taskx6004/eMate-CM4/README.md

# eMate-CM4
Yet another CM4 form-factor design for eMate laptop conversion kit.
