taskx6004/eMate-CM4/CM4_1S/step/BK11C0.6-10DS6-0.35V.stp

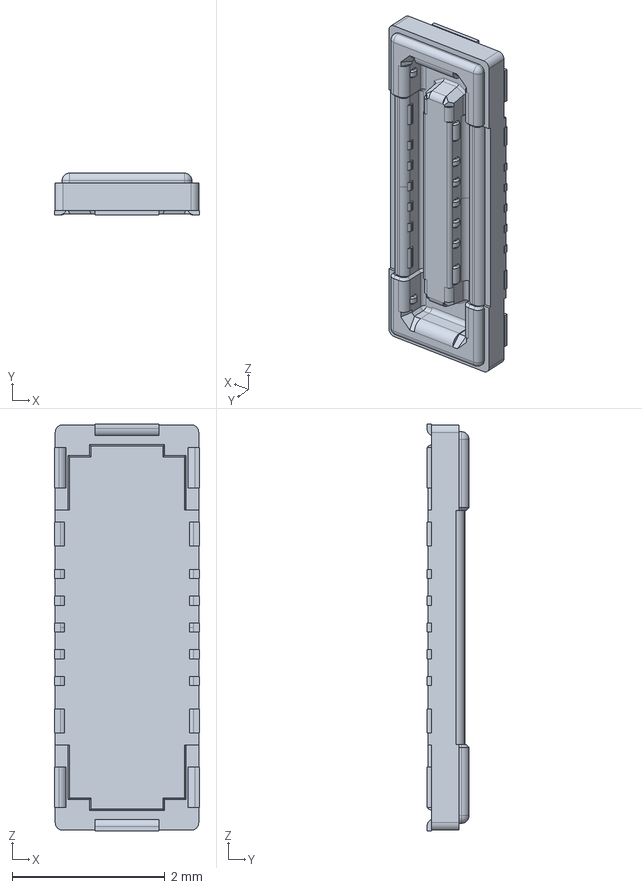
[picture p1: CAD file, 2024-03-10]
CM4_1S/step/BK11C0.6-10DS6-0.35V.stp
1.90 x 0.55 x 5.33 mm
