taskx6004/eMate-CM4/CM4_1S/step/FH34SRJ-22S-0.5SH(50).stp

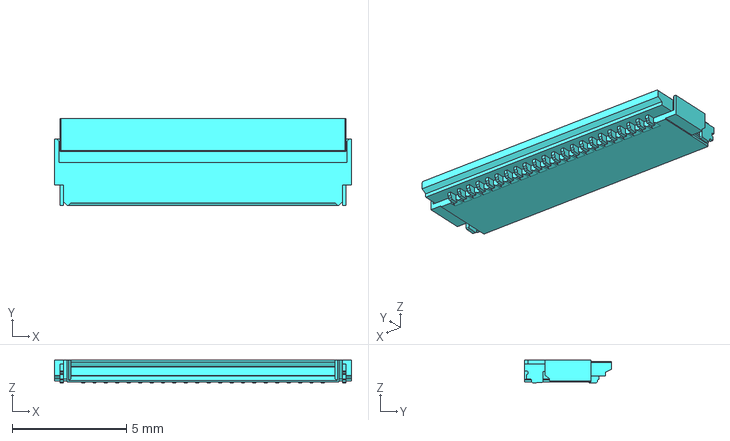
[picture p2: CAD file, 2024-03-10]
CM4_1S/step/FH34SRJ-22S-0.5SH(50).stp
13.0 x 3.80 x 1.00 mm
