taskx6004/eMate-CM4/CM4_1S/step/DF58-2P-1.2V.stp

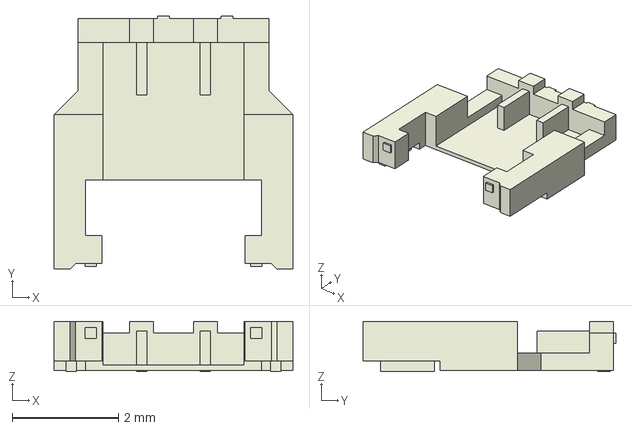
[picture p3: CAD file, 2024-03-10]
CM4_1S/step/DF58-2P-1.2V.stp
4.50 x 4.77 x 0.95 mm
