taskx6004/eMate-CM4/CM4_1S/step/SF72S006VB.step

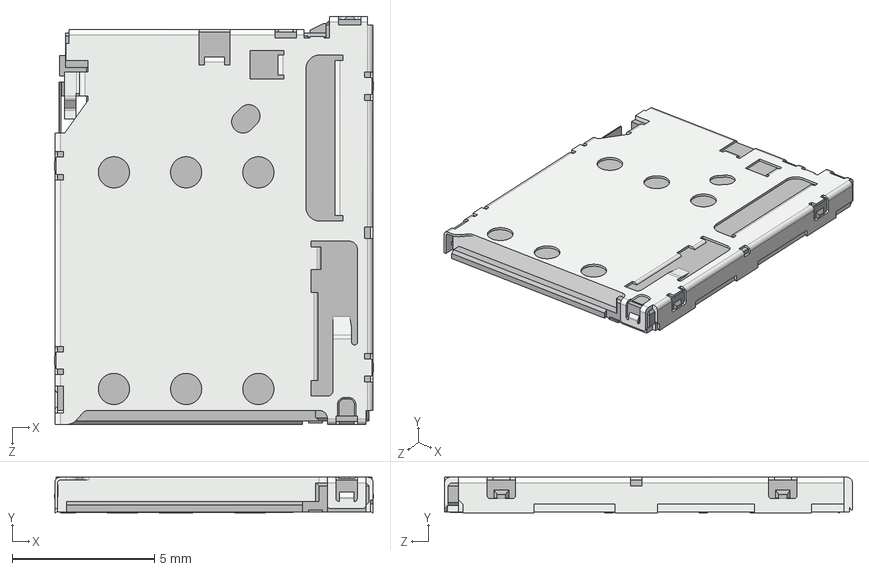
[picture p4: CAD file, 2024-03-10]
CM4_1S/step/SF72S006VB.step
11.2 x 1.25 x 14.4 mm
