taskx6004/eMate-CM4/CM4_1S/step/c-2199119-3-c-3d.stp

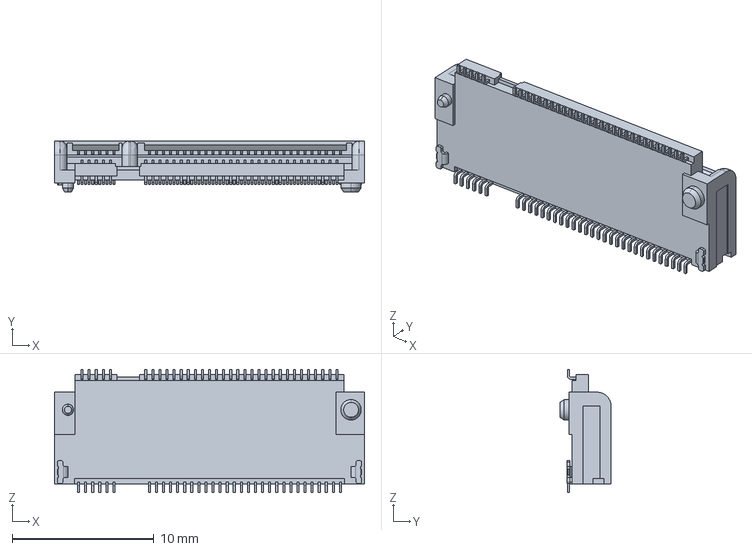
[picture p5: CAD file, 2024-03-10]
CM4_1S/step/c-2199119-3-c-3d.stp
21.9 x 3.62 x 8.70 mm
