taskx6004/eMate-CM4/CM4_1S/step/DF65-6P-1.7V.stp

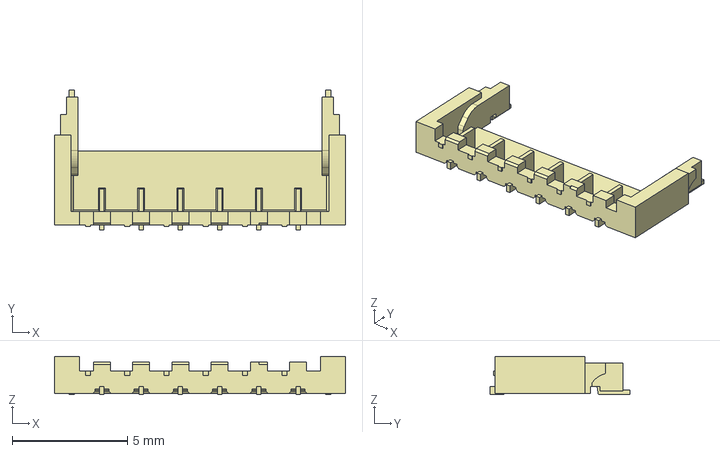
[picture p6: CAD file, 2024-03-10]
CM4_1S/step/DF65-6P-1.7V.stp
12.6 x 6.05 x 1.65 mm
