taskx6004/eMate-CM4/CM4_1S/step/2171790001.stp

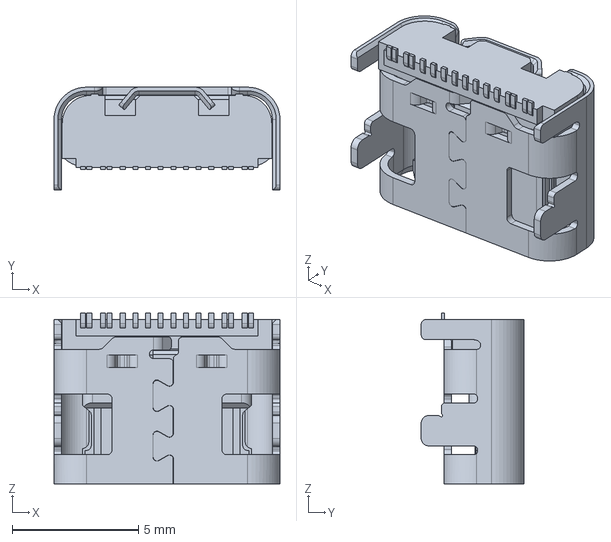
[picture p7: CAD file, 2024-03-10]
CM4_1S/step/2171790001.stp
8.94 x 4.06 x 6.75 mm
