taskx6004/eMate-CM4/CM4_1S/step/9774015151R.step

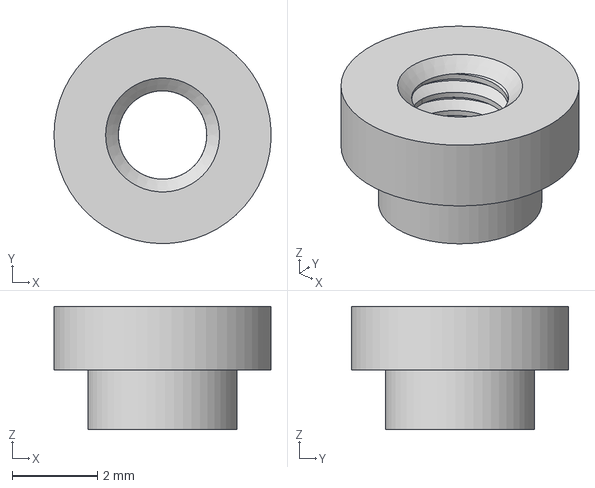
[picture p8: CAD file, 2024-03-10]
CM4_1S/step/9774015151R.step
5.10 x 5.10 x 2.90 mm
