taskx6004/eMate-CM4/CM4_1S/step/2012670005.stp

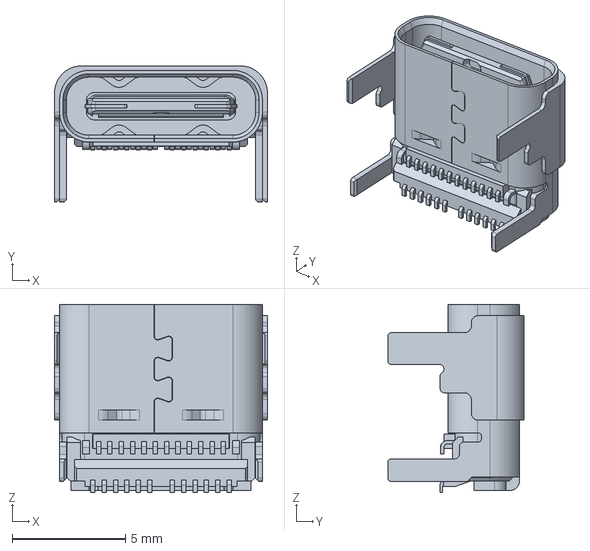
[picture p9: CAD file, 2024-03-10]
CM4_1S/step/2012670005.stp
9.39 x 6.01 x 8.30 mm
