taskx6004/eMate-CM4/CM4_1S/step/2171750001.stp

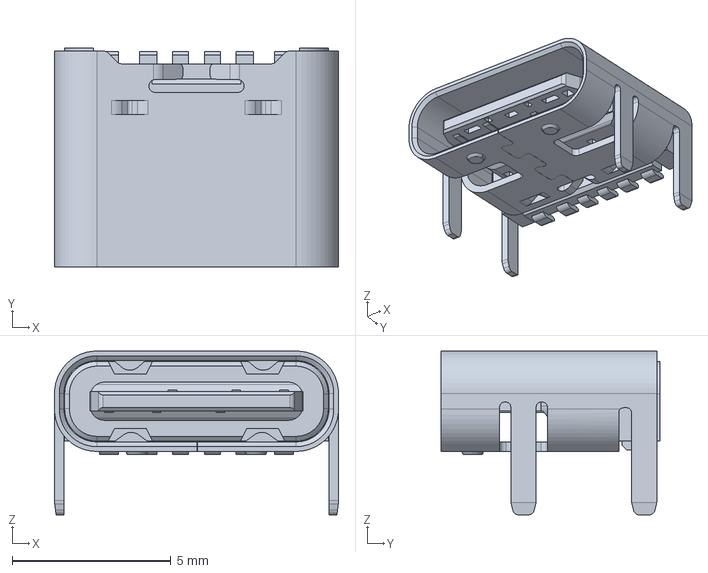
[picture p10: CAD file, 2024-03-10]
CM4_1S/step/2171750001.stp
8.94 x 6.90 x 5.16 mm
