taskx6004/eMate-CM4/CM4_1S/step/1050171001.stp

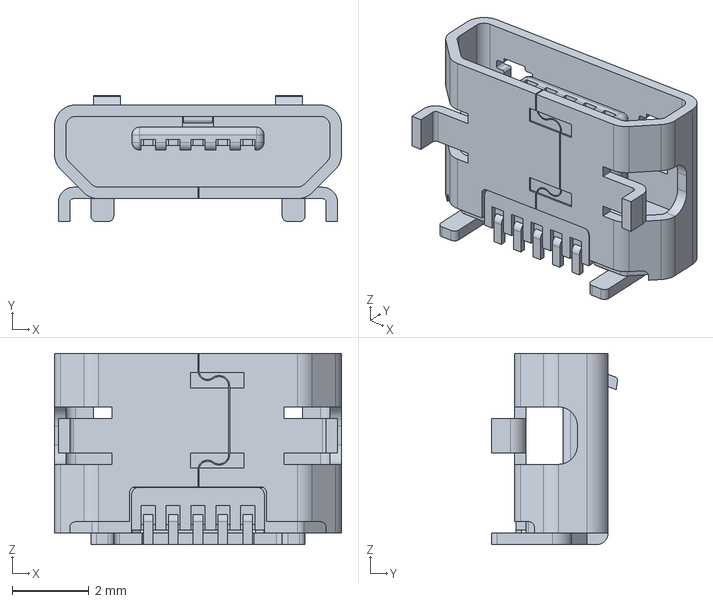
[picture p11: CAD file, 2024-03-10]
CM4_1S/step/1050171001.stp
7.50 x 3.30 x 5.00 mm
