taskx6004/eMate-CM4/CM4_1S/step/467651001.stp

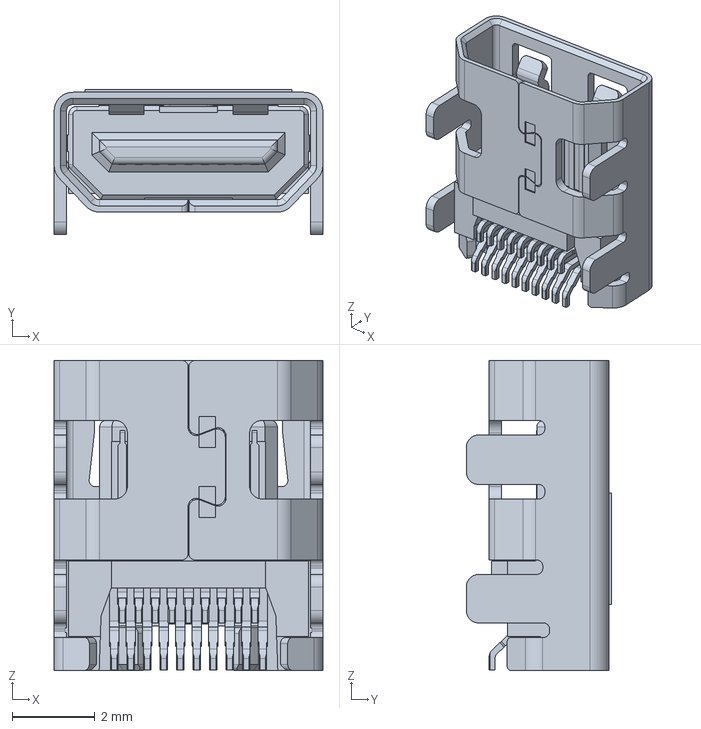
[picture p12: CAD file, 2024-03-10]
CM4_1S/step/467651001.stp
6.50 x 3.52 x 7.50 mm
