taskx6004/eMate-CM4/CM4_1S/step/5033981892.step

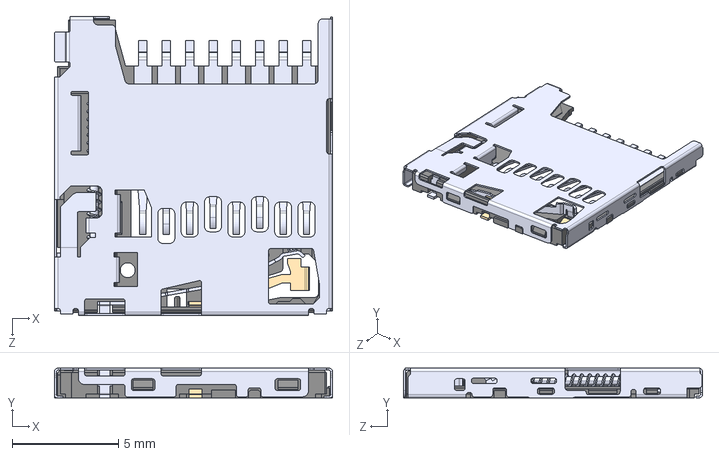
[picture p13: CAD file, 2024-03-10]
CM4_1S/step/5033981892.step
13.1 x 1.40 x 14.1 mm
