taskx6004/eMate-CM4/CM4_1S.pdf

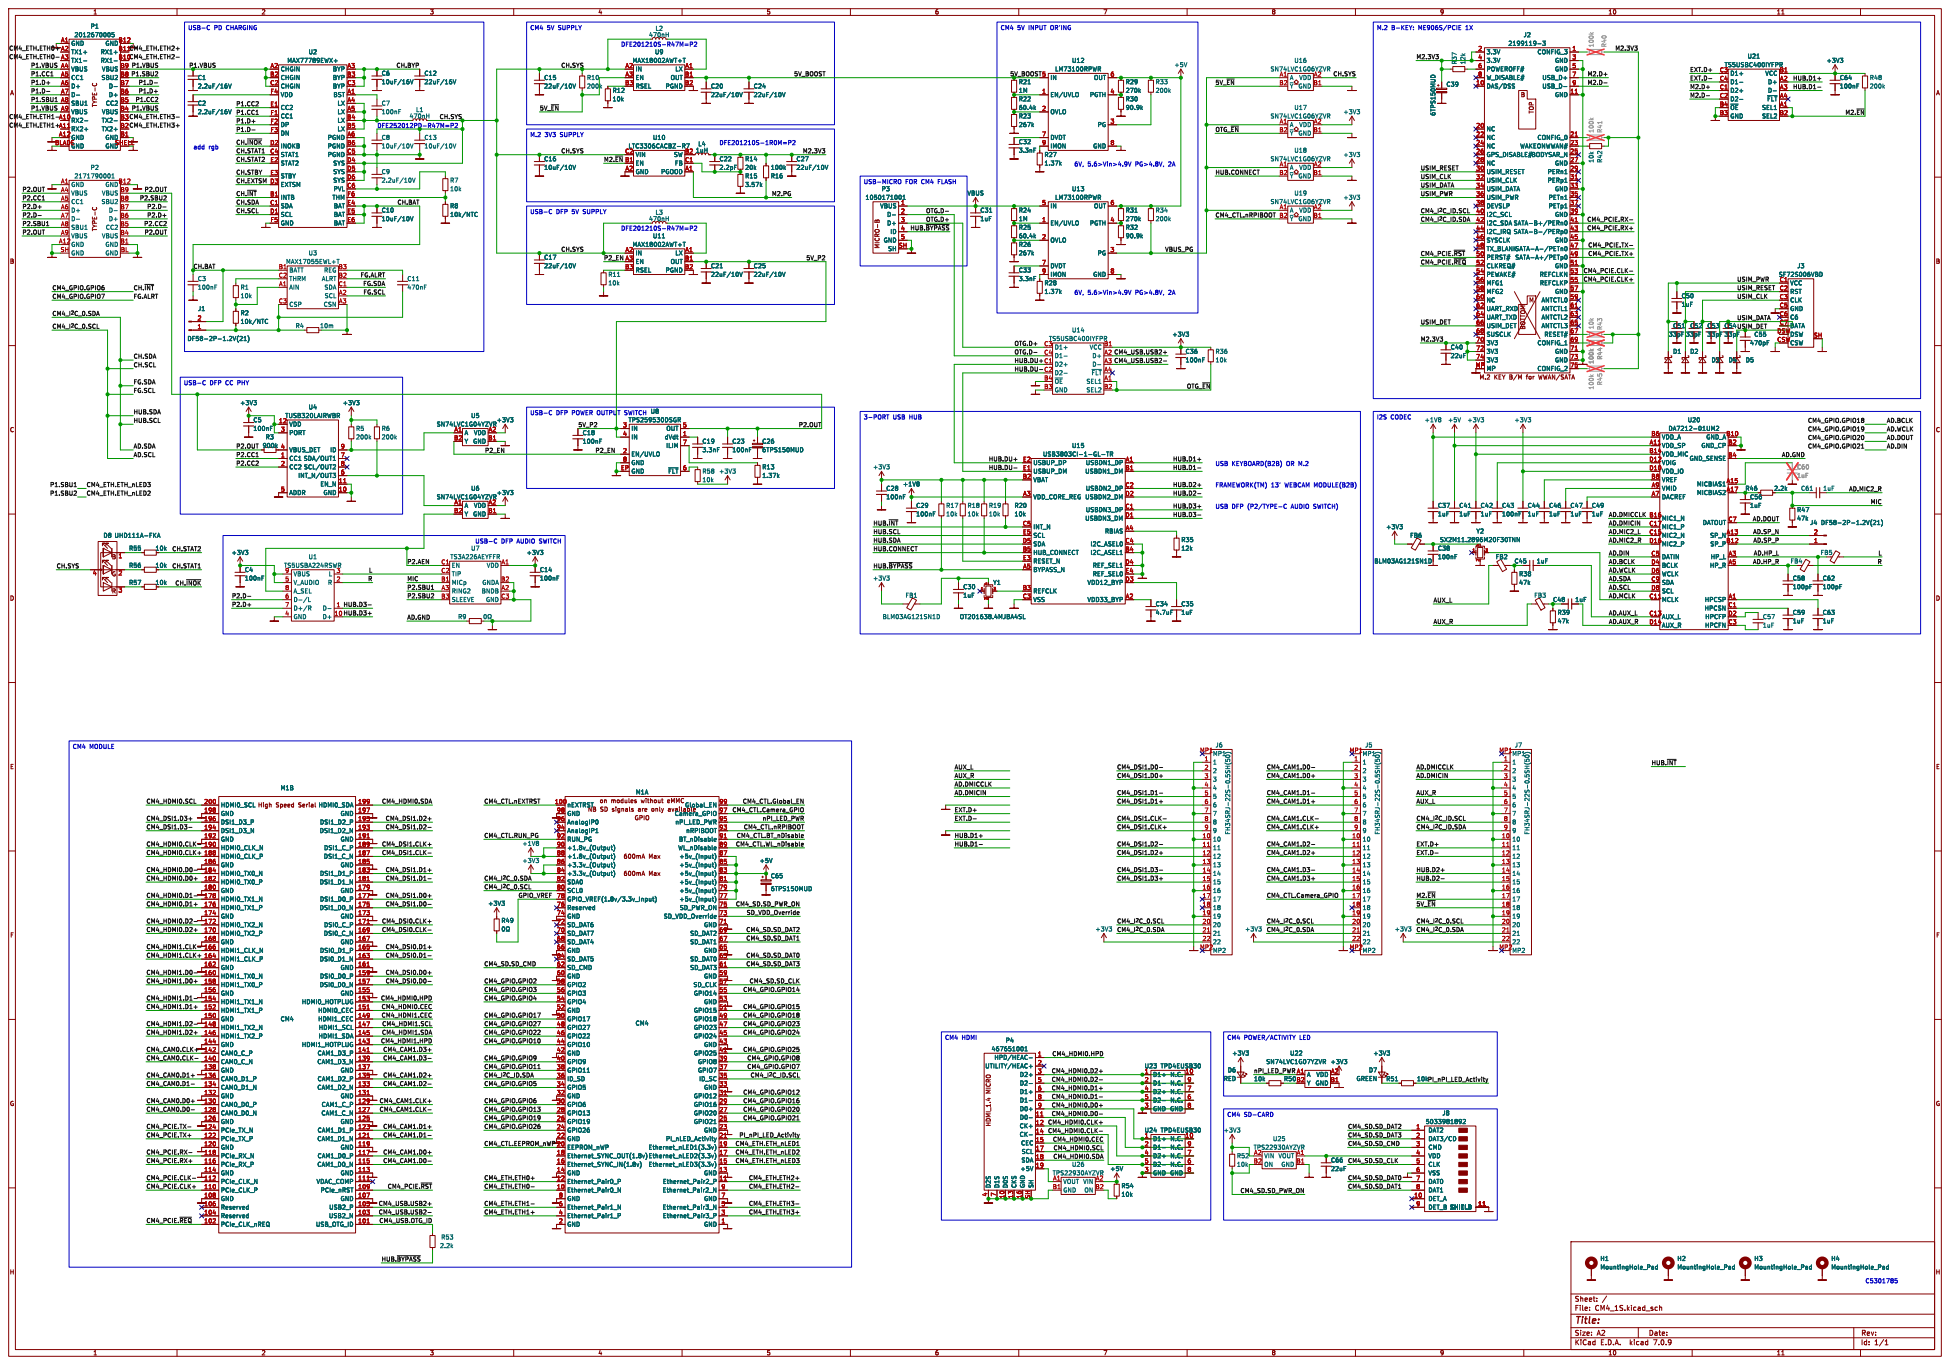
[picture p14: page 1]

CH.~{INOK} P1.D- P1.D+ P1.CC1 CH.SCL CH.EXTSM

ID 4 GND 5 VBUS 1 D- 2 D+ 3 SH SH

FG.SCL HUB.SCL HUB.SDA

USB-C DFP POWER OUTPUT SWITCH

AD.DOUT AD.BCLK
AD.WCLK

P2.CC2 P2.OUT P2.CC1 CH.STAT1 CH.~{INOK} CH.STAT2

C1 MCLK C11 AUX_L C13 MIC2_N
HUB.~{INT} AD.WCLK

EXT.D+ HUB.~{BYPASS} AD.GND HUB.D3+ HUB.D3-

AD.SCL AD.MCLK

600mA Max 600mA Max NB SD signals are only available
