taskx6004/eMate-CM4/eMate_CM4_KB.pdf

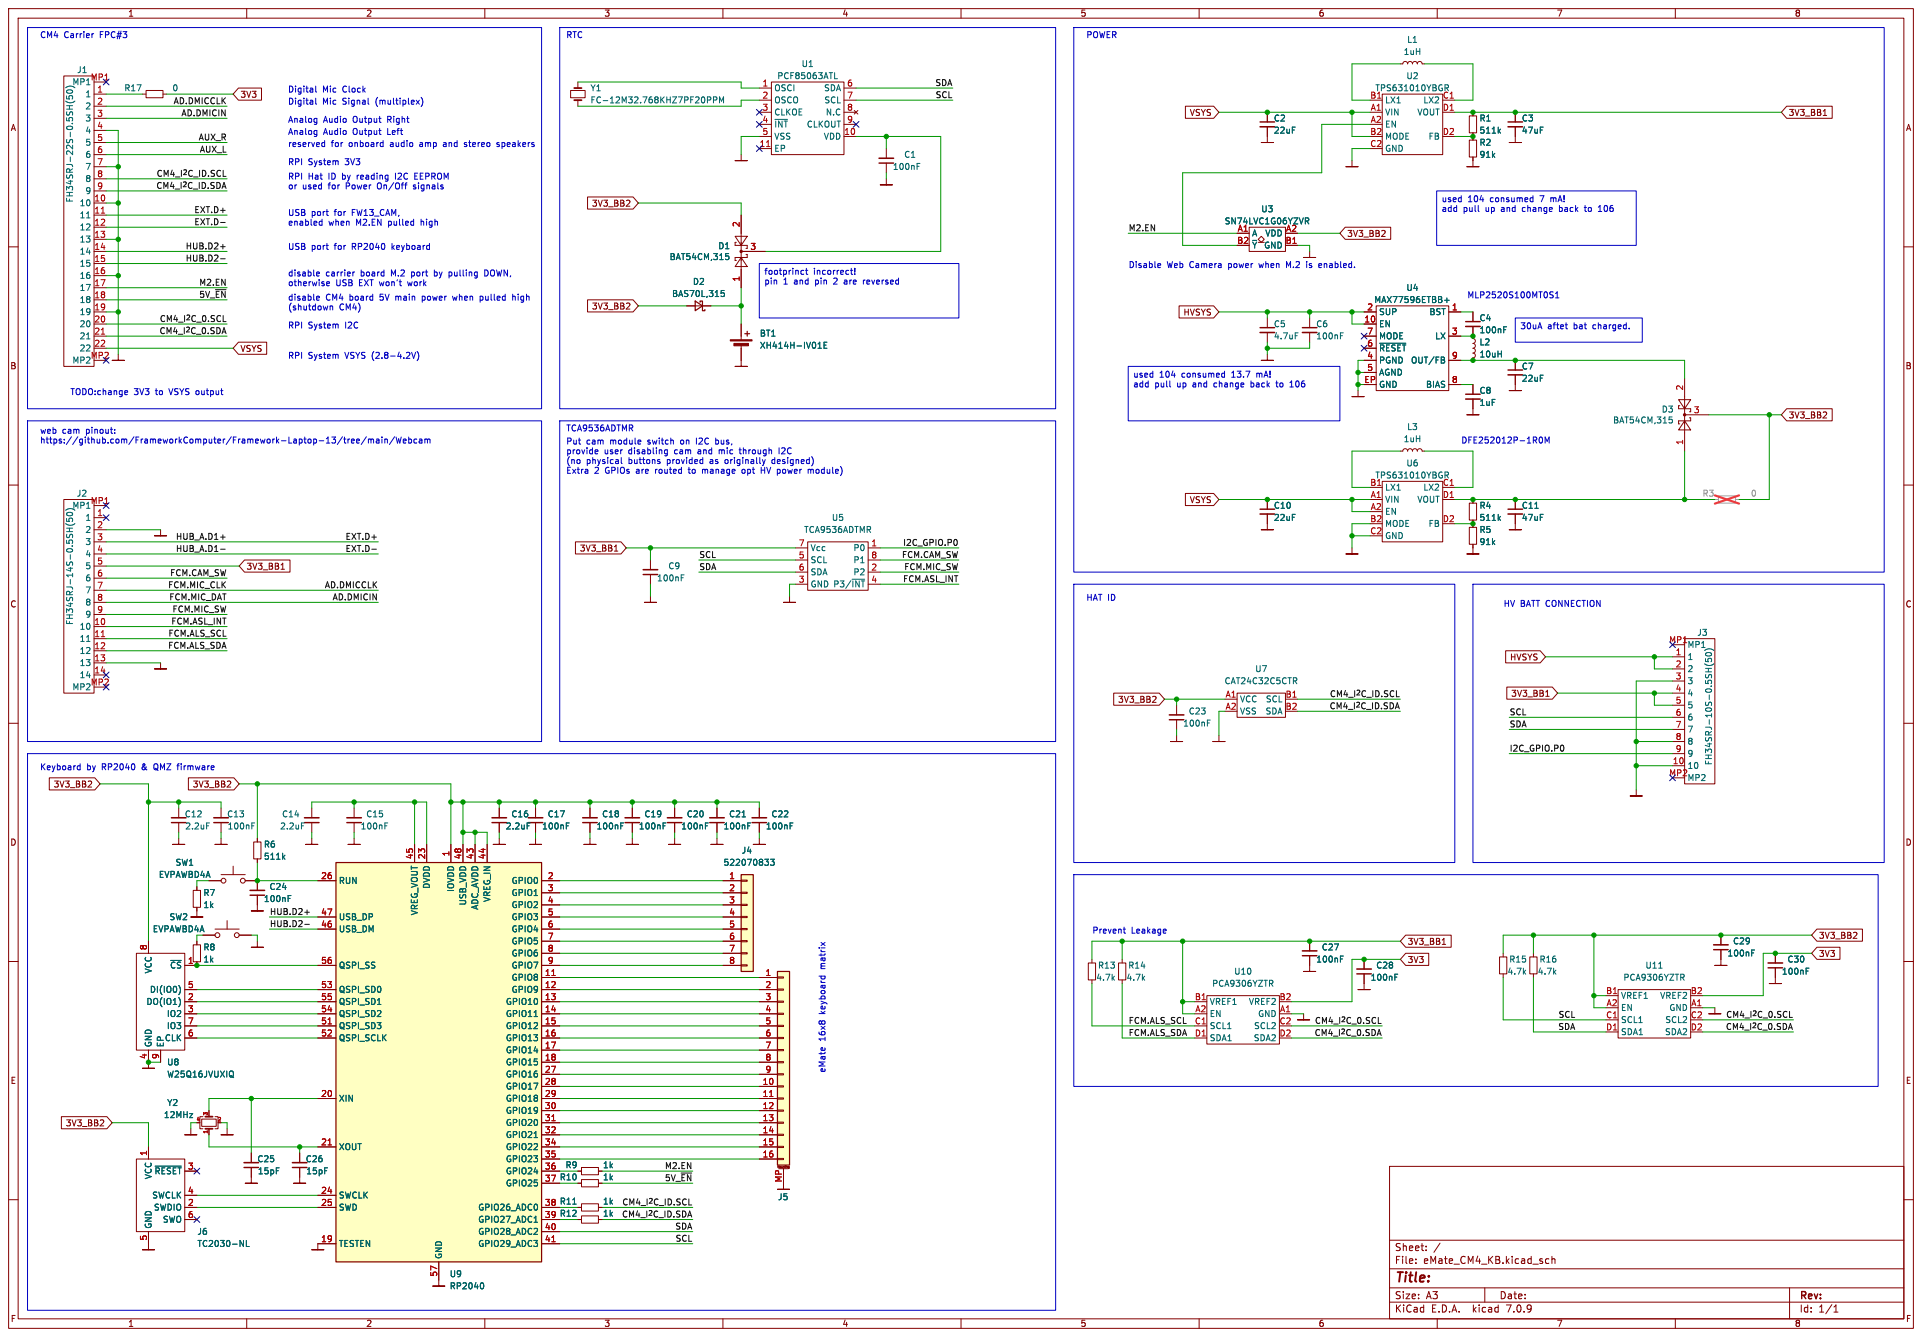
[picture p15: page 1]

1 2 D1 3 BAT54CM,315 OSCI 1 VDD 10 EP 11 OSCO 2 CLKOE 3 ~{INT} 4 VSS 5 SDA 6 SCL 7 N.C 8 CLKOUT 9 U1 PCF85063ATL

Digital Mic Signal (multiplex) RPI Hat ID by reading I2C EEPROM
Analog Audio Output Right USB port for RP2040 keyboard
Analog Audio Output Left RPI System 3V3
reserved for onboard audio amp and stereo speakers disable CM4 board 5V main power when pulled high

FCM.ASL_INT HUB.D2- EXT.D- HUB.D2+ AD.DMICCLK
AD.DMICIN

Prevent Leakage HAT ID eMate 16x8 keyboard matrix

Keyboard by RP2040 & QMZ firmware

1 GPIO8 11 GPIO9 12 GPIO10 13 GPIO11 14 GPIO12 15 GPIO13 16 GPIO14 17 GPIO15 18 TESTEN 19 GPIO0 2 XIN 20 XOUT 21 DVDD 23 SWCLK 24 SWD 25 RUN 26 GPIO16 27 GPIO17 28 GPIO18 29 GPIO1 3 GPIO19 30 GPIO20 31 GPIO21 32 GPIO22 34 GPIO23 35 GPIO24 36 GPIO25 37 GPIO26_ADC0 38 GPIO27_ADC1 39 GPIO2 4 GPIO28_ADC2 40 GPIO29_ADC3 41 ADC_AVDD 43 VREG_IN 44 VREG_VOUT 45 USB_DM 46 USB_DP 47 USB_VDD 48 GPIO3 5 QSPI_SD3 51 QSPI_SCLK 52 QSPI_SD0 53 QSPI_SD2 54 QSPI_SD1 55 QSPI_SS 56 GND 57 GPIO4 6 GPIO5 7 GPIO6 8 GPIO7 9 U9 RP2040

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

1 SWDIO 2 ~{RESET}3 SWCLK 4 GND

Id: 1/1 Title: File: eMate_CM4_KB.kicad_sch Sheet: /
