taskx6004/eMate-CM4/eMate_CM4_KB/eMate_CM4_KB.kicad_pcb

## KiCad design eMate_CM4_KB/eMate_CM4_KB.kicad_pcb (2024-03-10)

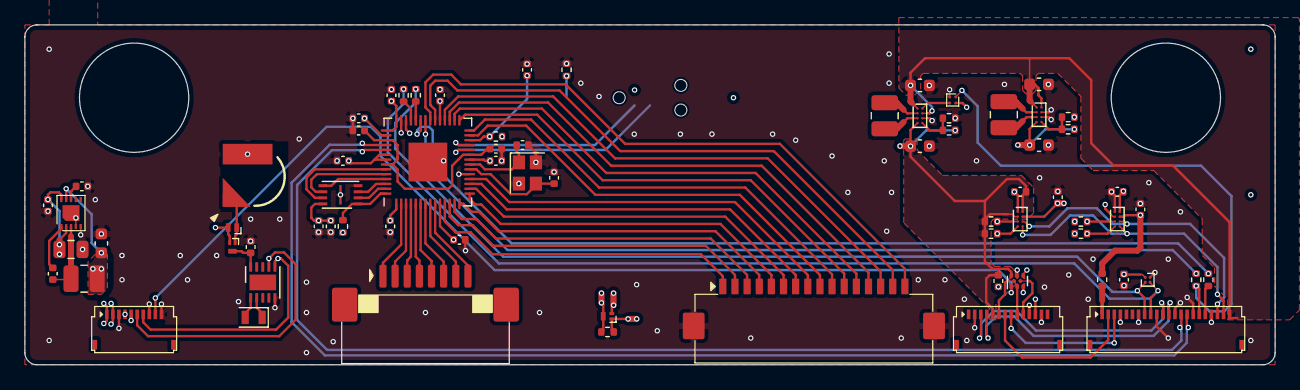
[picture p16: board eMate_CM4_KB.kicad_pcb from above]

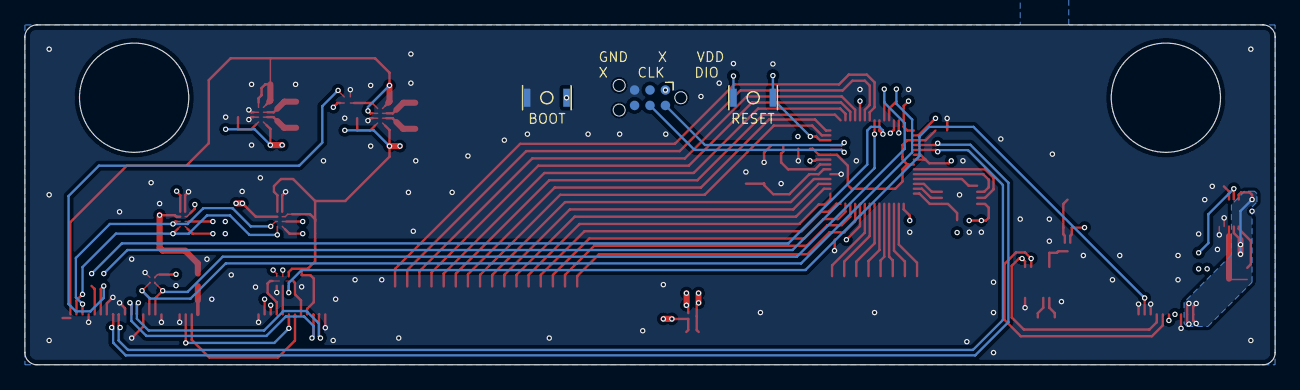
[picture p17: board eMate_CM4_KB.kicad_pcb from below]

Board: 4 copper layers, 103.0 x 28.0 mm, 75 parts (3 on the bottom side), 85 nets.

Parts:
BT1: XH414HG-IV01E
C1, C4, C6, C9, C13, C15, C17, C18, C19, C20, C21, C22, C23, C24, C27, C28, C29, C30: 100nF; C_0402_1005Metric
C2, C7, C10: 22uF; C_0603_1608Metric
C3, C11: 47uF; C_0603_1608Metric
C5: 4.7uF; C_0805_2012Metric
C8: 1uF; C_0402_1005Metric
C12, C14, C16: 2.2uF; C_0402_1005Metric
C25, C26: 15pF; C_0402_1005Metric
D1, D3: BAT54CM,315; Diodes_DFN1006-3
D2: BAS70L,315; Diodes_DFN1006-2
J1: FH34SRJ-22S-0.5SH(50)
J2: FH34SRJ-14S-0.5SH(50)
J3: FH34SRJ-10S-0.5SH(50)
J4: 522070833
J5: FH12-16S-1SH(55)
J6: TC2030-NL
L1, L3: 1uH; L_1008_2520Metric
L2: 10uH; L_1008_2520Metric
R1, R4, R6: 511k; R_0402_1005Metric
R2, R5: 91k; R_0402_1005Metric
R3, R17: 0; R_0402_1005Metric
R7, R8, R9, R10, R11, R12: 1k; R_0402_1005Metric
R13, R14, R15, R16: 4.7k; R_0402_1005Metric
SW1, SW2: EVPAWBD4A; EVPAWBA2A
U1: PCF85063ATL; DFN-10-1EP_2.6x2.6mm_P0.5mm_EP1.3x2.2mm
U2, U6: TPS631010YBGR; Texas_DSBGA-8_0.705x1.468mm_Layout2x4_P0.4mm
U3: SN74LVC1G06YZVR
U4: MAX77596ETBB+; MAX77596ETBB+T
U5: TCA9536ADTMR
U7: CAT24C32C5CTR; WLP-4_0.83x0.83mm_P0.4mm
U8: W25Q16JVUXIQ
U9: RP2040; QFN-56-1EP_7x7mm_P0.4mm_EP3.2x3.2mm
U10, U11: PCA9306YZTR; Texas_DSBGA-8_0.705x1.468mm_Layout2x4_P0.4mm
Y1: FC-12M32.768KHZ7PF20PPM; Crystal_SMD_2012-2Pin_2.0x1.2mm
Y2: 12MHz; Crystal_SMD_2520-4Pin_2.5x2.0mm

Connections:
3V3: C28.2, C30.2, R17.2, U10.B2 (VREF2), U11.B2 (VREF2)
3V3_BB1: C3.1, C9.2, C27.2, J2.5, J3.4, J3.5, R1.1, R13.2, R14.2, U2.D1 (VOUT), U5.7 (Vcc), U10.A2 (EN), U10.B1 (VREF1)
3V3_BB2: C12.2, C13.2, C16.2, C17.2, C18.2, C19.2, C20.2, C21.2, C22.2, C23.2, C29.2, D1.2, D2.2 (A), D3.3, J6.1 (VCC), R3.2, R6.1, R15.2, R16.2, U3.A2 (VDD), U7.A1 (VCC), U8.8 (VCC), U9.1 (IOVDD), U9.10 (IOVDD), U9.22 (IOVDD), U9.33 (IOVDD), U9.42 (IOVDD), U9.43 (ADC_AVDD), U9.44 (VREG_IN), U9.48 (USB_VDD), U9.49 (IOVDD), U11.A2 (EN), U11.B1 (VREF1)
/5V_~EN: J1.18, R10.2
/AD.DMICCLK: J1.2, J2.7
/AD.DMICIN: J1.3, J2.8
/CM4_I^{2}C_0.SCL: J1.20, U10.C2 (SCL2), U11.C2 (SCL2)
/CM4_I^{2}C_0.SDA: J1.21, U10.D2 (SDA2), U11.D2 (SDA2)
/CM4_I^{2}C_ID.SCL: J1.8, R11.2, U7.B1 (SCL)
/CM4_I^{2}C_ID.SDA: J1.9, R12.2, U7.B2 (SDA)
/EXT.D+: J1.11, J2.3
/EXT.D-: J1.12, J2.4
/FCM.ALS_SCL: J2.11, R13.1, U10.C1 (SCL1)
/FCM.ALS_SDA: J2.12, R14.1, U10.D1 (SDA1)
/FCM.ASL_INT: J2.10, U5.4 (P3/~INT)
/FCM.CAM_SW: J2.6, U5.8 (P1)
/FCM.MIC_SW: J2.9, U5.2
/HUB.D2+: J1.14, U9.47 (USB_DP)
/HUB.D2-: J1.15, U9.46 (USB_DM)
/I2C_GPIO.P0: J3.9, U5.1 (P0)
/M2.EN: J1.17, R9.2, U3.A1 (A)
/SCL: J3.6, R15.1, U1.7 (SCL), U5.5 (SCL), U9.41 (GPIO29_ADC3), U11.C1 (SCL1)
/SDA: J3.7, R16.1, U1.6 (SDA), U5.6 (SDA), U9.40 (GPIO28_ADC2), U11.D1 (SDA1)
GND: BT1.2 (-), C1.1, C2.2, C3.2, C5.2, C6.2, C7.2, C8.2, C9.1, C10.2, C11.2, C12.1, C13.1, C14.1, C15.1, C16.1, C17.1, C18.1, C19.1, C20.1, C21.1, C22.1, C23.1, C24.1, C25.1, C26.1, C27.1, C28.1, C29.1, C30.1, J1.4, J1.7, J1.10, J1.13, J1.16, J1.19, J2.2, J2.13, J3.3, J3.8, J3.10, J5.MP (MountPin), J6.5 (GND), R2.2, R5.2, R7.2, SW2.2, U1.5 (VSS), U2.C2 (GND), U3.B1 (GND), U4.4 (PGND), U4.5 (AGND), U4.EP (GND), U5.3 (GND), U6.B2 (MODE), U6.C2 (GND), U7.A2 (VSS), U8.4 (GND), U8.9 (EP), U9.19 (TESTEN), U9.57 (GND), U10.A1 (GND), U11.A1 (GND), Y2.2, Y2.4
HVSYS: C5.1, C6.1, J3.1, J3.2, U4.2 (SUP), U4.10 (EN)
unnamed: BT1.1 (+), D1.1, D2.1 (K)
unnamed: J1.1, R17.1
unnamed: J4.1, U9.2 (GPIO0)
unnamed: J4.2, U9.3 (GPIO1)
unnamed: J4.3, U9.4 (GPIO2)
unnamed: J4.4, U9.5 (GPIO3)
unnamed: J4.5, U9.6 (GPIO4)
unnamed: J4.6, U9.7 (GPIO5)
unnamed: J4.7, U9.8 (GPIO6)
unnamed: J4.8, U9.9 (GPIO7)
unnamed: J5.1, U9.11 (GPIO8)
unnamed: J5.2, U9.12 (GPIO9)
unnamed: J5.3, U9.13 (GPIO10)
unnamed: J5.4, U9.14 (GPIO11)
unnamed: J5.5, U9.15 (GPIO12)
unnamed: J5.6, U9.16 (GPIO13)
unnamed: J5.7, U9.17 (GPIO14)
unnamed: J5.8, U9.18 (GPIO15)
unnamed: J5.9, U9.27 (GPIO16)
unnamed: J5.10, U9.28 (GPIO17)
unnamed: J5.11, U9.29 (GPIO18)
unnamed: J5.12, U9.30 (GPIO19)
unnamed: J5.13, U9.31 (GPIO20)
unnamed: J5.14, U9.32 (GPIO21)
unnamed: J5.15, U9.34 (GPIO22)
unnamed: J5.16, U9.35 (GPIO23)
unnamed: J6.4 (SWCLK), U9.24 (SWCLK)
unnamed: J6.2 (SWDIO), U9.25 (SWD)
unnamed: R7.1, SW1.1
unnamed: R8.1, SW2.1
unnamed: U1.1 (OSCI), Y1.2
unnamed: U1.2 (OSCO), Y1.1
unnamed: C1.2, D1.3, U1.10 (VDD)
unnamed: U2.A2 (EN), U3.B2 (~Y)
unnamed: R1.2, R2.1, U2.D2 (FB)
unnamed: L1.1, U2.B1 (LX1)
unnamed: L1.2, U2.C1 (LX2)
unnamed: C8.1, U4.8 (BIAS)
unnamed: C4.1, U4.1 (BST)
unnamed: C4.2, L2.1, U4.3 (LX)
unnamed: C7.1, D3.2, L2.2, U4.9 (OUT/FB)
unnamed: R4.2, R5.1, U6.D2 (FB)
unnamed: L3.1, U6.B1 (LX1)
unnamed: L3.2, U6.C1 (LX2)
unnamed: C11.1, D3.1, R3.1, R4.1, U6.D1 (VOUT)
unnamed: U8.6 (CLK), U9.52 (QSPI_SCLK)
unnamed: U8.5 (DI(IO0)), U9.53 (QSPI_SD0)
unnamed: U8.2 (DO(IO1)), U9.55 (QSPI_SD1)
unnamed: U8.3 (IO2), U9.54 (QSPI_SD2)
unnamed: U8.7 (IO3), U9.51 (QSPI_SD3)
unnamed: R8.2, U8.1 (~CS), U9.56 (QSPI_SS)
unnamed: R9.1, U9.36 (GPIO24)
unnamed: R10.1, U9.37 (GPIO25)
unnamed: R11.1, U9.38 (GPIO26_ADC0)
unnamed: R12.1, U9.39 (GPIO27_ADC1)
unnamed: C24.2, R6.2, SW1.2, U9.26 (RUN)
unnamed: C14.2, C15.2, U9.23 (DVDD), U9.45 (VREG_VOUT), U9.50 (DVDD)
unnamed: C25.2, U9.20 (XIN), Y2.3
unnamed: C26.2, U9.21 (XOUT), Y2.1
VSYS: C2.1, C10.1, J1.22, U2.A1 (VIN), U2.B2 (MODE), U6.A1 (VIN), U6.A2 (EN)
