taskx6004/eMate-CM4/(commit log)

2024-03-10 inital commit
    inital commit, designs are tested with actual PCBA
    [1050171001.stp, 2012670005.stp, 2171750001.stp, 2171790001.stp, 467651001.stp, 5033981892.step, 9774015151R.step, BK11C0.6-10DS6-0.35V.stp]
2024-03-18 add schematic in PDF form
